danny6869/midi-ble-footswitch/MidiBLEProtocol.h

#pragma once

#include <BLEPeripheral.h>
#include <Arduino.h>

#ifndef DMIDIBLEUTIL_H
#define DMIDIBLEUTIL_H

// MIDI Channels
#define MIDI_CHANNEL_1  1
#define MIDI_CHANNEL_2  2
#define MIDI_CHANNEL_3  3
#define MIDI_CHANNEL_4  4
#define MIDI_CHANNEL_5  5
#define MIDI_CHANNEL_6  6
#define MIDI_CHANNEL_7  7
#define MIDI_CHANNEL_8  8
#define MIDI_CHANNEL_9  9
#define MIDI_CHANNEL_10 10
#define MIDI_CHANNEL_11 11
#define MIDI_CHANNEL_12 12
#define MIDI_CHANNEL_13 13
#define MIDI_CHANNEL_14 14
#define MIDI_CHANNEL_15 15
#define MIDI_CHANNEL_16 16

// MIDI Control Change (CC) Numbers
#define MIDI_CC_CONTROL_0	0
#define MIDI_CC_CONTROL_1	1
#define MIDI_CC_CONTROL_2	2
#define MIDI_CC_CONTROL_3	3
#define MIDI_CC_CONTROL_4	4
#define MIDI_CC_CONTROL_5	5
#define MIDI_CC_CONTROL_6	6
#define MIDI_CC_CONTROL_7	7
#define MIDI_CC_CONTROL_8	8
#define MIDI_CC_CONTROL_9	9
#define MIDI_CC_CONTROL_10	10
#define MIDI_CC_CONTROL_11	11
#define MIDI_CC_CONTROL_12	12
#define MIDI_CC_CONTROL_13	13
#define MIDI_CC_CONTROL_14	14
#define MIDI_CC_CONTROL_15	15
#define MIDI_CC_CONTROL_16	16
#define MIDI_CC_CONTROL_17	17
#define MIDI_CC_CONTROL_18	18
#define MIDI_CC_CONTROL_19	19
#define MIDI_CC_CONTROL_20	20
#define MIDI_CC_CONTROL_21	21
#define MIDI_CC_CONTROL_22	22
#define MIDI_CC_CONTROL_23	23
#define MIDI_CC_CONTROL_24	24
#define MIDI_CC_CONTROL_25	25
#define MIDI_CC_CONTROL_26	26
#define MIDI_CC_CONTROL_27	27
#define MIDI_CC_CONTROL_28	28
#define MIDI_CC_CONTROL_29	29
#define MIDI_CC_CONTROL_30	30
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
#define MIDI_NOTE_E7    100
#define MIDI_NOTE_F7    101
#define MIDI_NOTE_Gb7   102
#define MIDI_NOTE_G7    103
#define MIDI_NOTE_Ab7   104
#define MIDI_NOTE_A7    105
#define MIDI_NOTE_Bb7   106
#define MIDI_NOTE_B7    107
#define MIDI_NOTE_C8    108
#define MIDI_NOTE_Db8   109
#define MIDI_NOTE_D8    110
#define MIDI_NOTE_Eb8   111
#define MIDI_NOTE_E8    112
#define MIDI_NOTE_F8    113
#define MIDI_NOTE_Gb8   114
#define MIDI_NOTE_G8    115
#define MIDI_NOTE_Ab8   116
#define MIDI_NOTE_A8    117
#define MIDI_NOTE_Bb8   118
#define MIDI_NOTE_B8    119
#define MIDI_NOTE_C9    120
#define MIDI_NOTE_Db9   121
#define MIDI_NOTE_D9    122
#define MIDI_NOTE_Eb9   123
#define MIDI_NOTE_E9    124
#define MIDI_NOTE_F9    125
#define MIDI_NOTE_Gb9   126
#define MIDI_NOTE_G9    127

struct MidiBlePacket {
  byte *data;
  int size;
};

class MidiBLEProtocol {
  private:
    static byte *generateHeaderBytes();
  public:
    static MidiBlePacket *generateNoteOnOffPacket(int channelNumber, int noteNumber, bool onOff);
    static MidiBlePacket *generateControlChangePacket(int channelNumber, int controlNumber, int controlPosition);
    static void logMidiPacket(MidiBlePacket * packet);
};

#endif
