danny6869/midi-ble-footswitch/MidiBLEDevice.h

#include <BLEPeripheral.h>
#include "MidiBLEProtocol.h"

#ifndef DMIDIBLEDEVICE_H
#define DMIDIBLEDEVICE_H

class MidiBLEDevice {

  private:

    // Setup our bluetooth device according to the MIDI BLE spec...
    BLEPeripheral *blePeripheral;
    BLEService *bleService;
    BLEDescriptor *bleDescriptor;
    BLECharacteristic *bleCharacteristic;

    void sendMidiBlePacket( MidiBlePacket *packet );

  public:

    char *deviceName;

    MidiBLEDevice( char *cDeviceName );
    void loop();

    bool hasSubscriberConnected();

    void sendMIDINoteOff( int midi_channel, int midi_note );
    void sendMIDINoteOn( int midi_channel, int midi_note );
    void sendMIDIControlChange( int midi_channel, int midi_control_number, int midi_control_position );

};

#endif
