danny6869/midi-ble-footswitch/MidiExpressionPedal.h

#include "MidiBLEDevice.h"
#include "IMidiControllerComponent.h"

#pragma once

#ifndef DMIDIEXPRESSIONPEDAL_H
#define DMIDIEXPRESSIONPEDAL_H

// The response of the expression pedal
#define EXPRESSION_PEDAL_CURVE_LINEAR        1
#define EXPRESSION_PEDAL_CURVE_ACCELERATED   2
#define EXPRESSION_PEDAL_CURVE_DECELERATED   3

// The direction of the expression pedal
#define EXPRESSION_PEDAL_DIRECTION_LOW_TO_HIGH      1
#define EXPRESSION_PEDAL_DIRECTION_HIGH_TO_LOW      2

// Defines what is needed to make each button unit work...
class MidiExpressionPedal : public IMidiControllerComponent {
  public:
    int id;
    int button_pin;
    int midi_channel;
    int midi_control_number;
    int curve_type;
    int pedal_direction;
    MidiBLEDevice *midiBleDevice;

    MidiExpressionPedal( MidiBLEDevice *cMidiBleDevice, int cid, int cbutton_pin, int cmidi_channel, int cmidi_control_number, int cpedal_direction, int ccurve_type );
    void initGPIOPins();
    void handleState();
    void resetState();
  private:
    // To track our CC pedal value so we know when it changes...
    int last_midi_value;
};

#endif
