danny6869/midi-ble-footswitch/(commit log)

2020-02-05 Setup initial controller board
2020-02-05 Fixed method calling from broken linves that were originally commented
    [midi-ble-footswitch.ino]
2020-02-05 Fixed the chart to match the current default setup
2020-02-08 - Added constants for button presses - Moved init of gpio into each component class - Fixed bug with reset of LEDs upon disconnect/disconnect of subscriber - Default config has buttons being momentar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
    [MidiButton.cpp, MidiButton.h, MidiController.cpp, MidiController.h, MidiExpressionPedal.cpp, MidiExpressionPedal.h, config.h, midi-ble-footswitch.ino]
2020-02-08 Removed onboard button/LED from default config
2020-02-10 Changed pins of the first two buttons
2020-02-15 Added CC button functionality
2020-02-15 Using the common interface classes for note buttons
2020-02-15 Added CC button functionality to the main controller class
2020-02-15 Adjusted to allow any lighted button lists be passed to it
2020-02-15 Adjusted the main INO file to the new interface to add buttons
2020-02-15 Added new interface classes, and removed/move old button classes (replaces by new ones)
    [IMidiControllerComponent.h, IMidiLightedButton.h, MidiButton.cpp, MidiButton.h]
2020-02-16 Get the CC button actually sending the control change message (oops)
2020-02-16 Adjusted the commented out note buttons to match the readme, and getting rid of the expression pedals in the default config, or else they will get set to 0 by default ... which means volume off most 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
2020-02-16 By default, 4 buttons and 2 expression pedals. I will just have to put a warning in the README at some point.
2020-02-16 Fixed the directional calcs for accellerated and decelerated curves
    [MidiExpressionPedal.cpp]
2020-02-16 Fixed the directional stuff (actually undid what I did before, as it was not correct...visualizing is screwing with my head.
    [MidiExpressionPedal.cpp]
2020-02-23 Aded simple button assembly drawing, and some other info tot he readme
2020-02-23 Changed button/led pin chart header to match graphic cretaed
2020-03-02 Added a TODO for a file describing final assembly
2020-03-02 Added empty instruction files for soldering the different components
2020-03-02 Added instructions (1st pass) for how to update the board
2020-03-07 Adjusted the instructions for updating the board
2020-03-07 Finished the button/led instructiont
2020-03-13 Added link to connector page
2020-03-17 Added page for soldering the connectors to the BLE board
2020-03-17 Adjusted the connectors in the parts list, and some formatting
2020-03-17 Adjusted formatting on the button circuit page
2020-03-17 Added a few pictures of the microcontroller board solder points
2020-03-17 Added pictures of bitton solder points on the board
2020-03-17 Added wire colors to instructions for buttons
2020-03-17 Added wire colors to button circuit pictures
2020-03-17 Added connector picture for buttons
2020-03-17 Fixed button solder page, and added separate connector pictures
2020-03-17 Added connector photos for power, and exp pedal connectors (to board)
2020-03-17 Fixed expression pedal wire inventory list
2020-03-17 Adjusted wire colors in desctiptions and added a note to the power circuit page before I get started on that
2020-03-17 Added final assembly instructions (pictureless at this point)
2020-03-17 Added a new instruction page stub, and hot glue gun to the tools list
2020-03-18 Added final print pictures
2020-03-24 Added a donate button
2020-03-24 Using markdown for the donate button as it does not display on github otherwise
